matyoungblood/Chemical-Detector/HOUSING/diagram_files/7938.gif

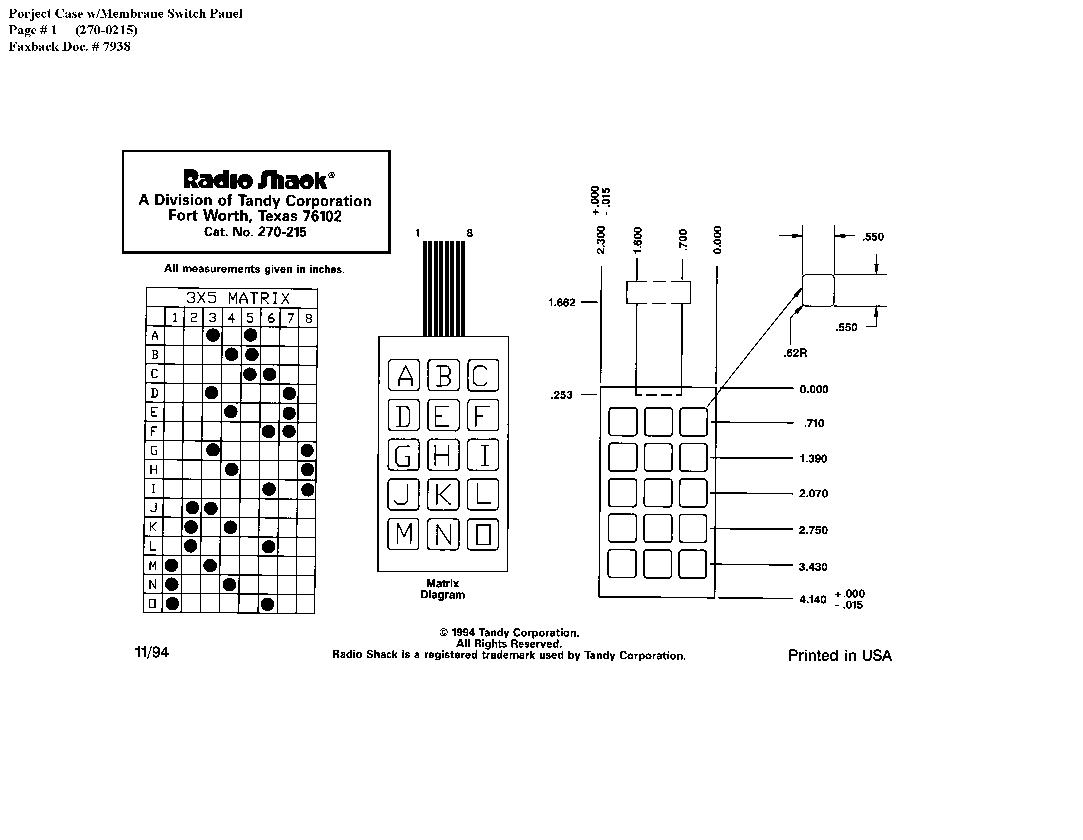
HOUSING/diagram_files/7938.gif
