matyoungblood/Chemical-Detector/HOUSING/diagram_files/7938002.gif

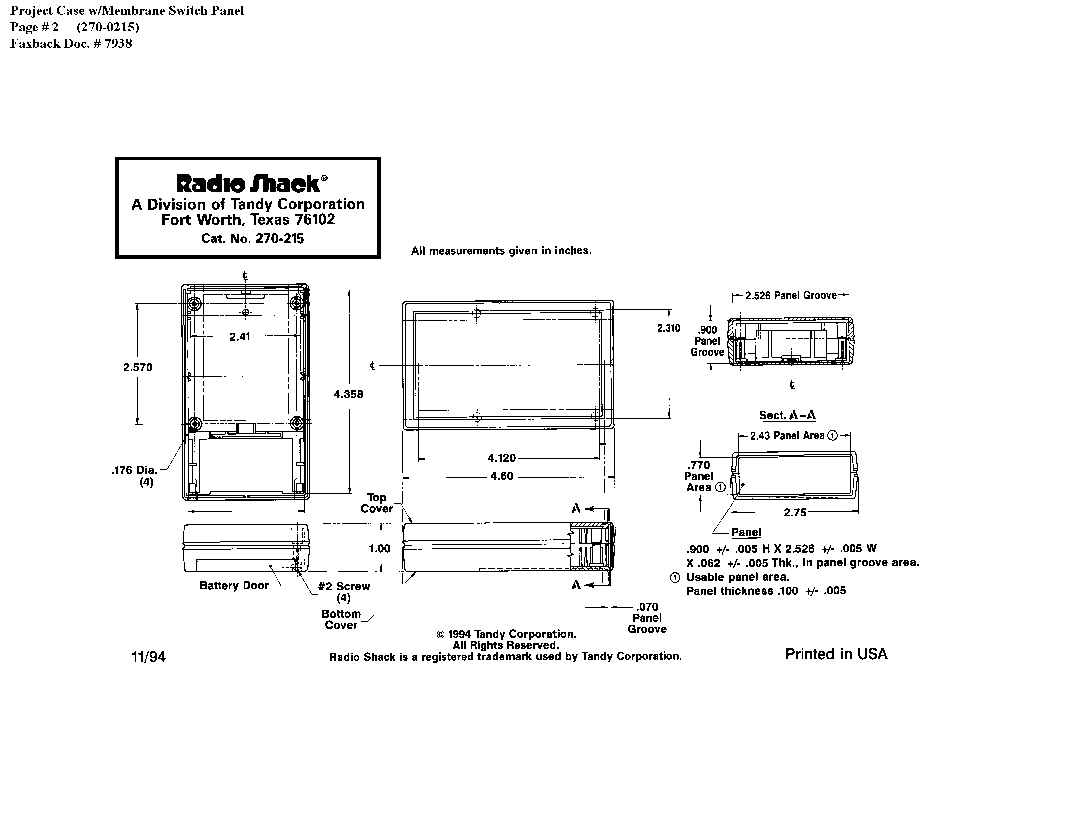
HOUSING/diagram_files/7938002.gif
