matyoungblood/Chemical-Detector/HOUSING/schematic_drawings_files/16198.gif

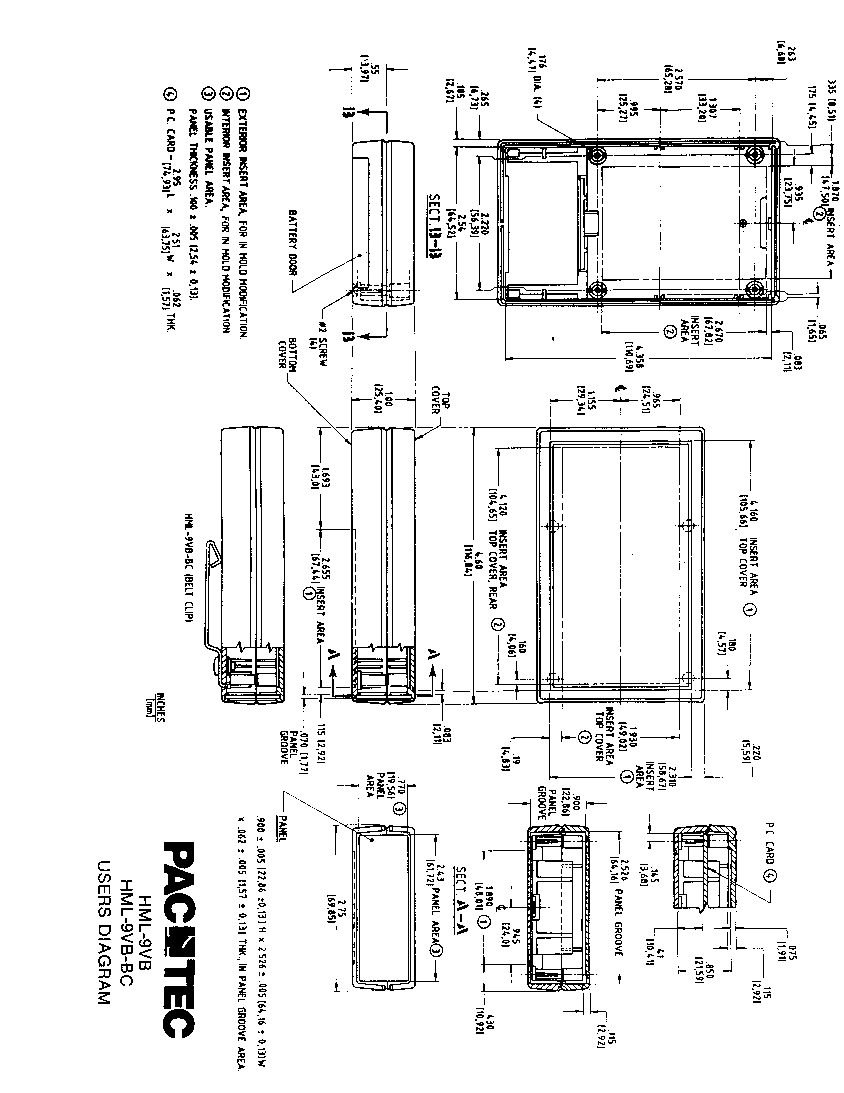
HOUSING/schematic_drawings_files/16198.gif
