matyoungblood/Chemical-Detector/PCB.modernformat/LAYOUT/TEST_POINT.txt

(DEVICE DESCRIPTION FILE: TEST_POINT)
PACKAGE TP_TP1
PACKAGEPROP HEIGHT '1.0000000'
PACKAGEPROP ALT_SYMBOLS '(TP_TP2;TP_TP3;TP;TP_TP5)'
CLASS IC
PINCOUNT 1
END
