matyoungblood/Chemical-Detector/(list of files, drawings)

Other design files:
SCHEMATICS/DESIGN1.DSN
SCHEMATICS/DESIGN1.opj
