matyoungblood/Chemical-Detector/(commit log)

2021-10-02 Initial Work
    2003 Senior Design Project
    [2_to_the_x_lookup_table_sketchpad.xls, 3_24_03.xls, 4_7_2003.xls, DESIGN1.DSN, DESIGN1.opj, FINAL_SENSOR_DATA.xls, coefficients.xls, coefficients_for_calculating_dose.xls]
2021-10-03 Upgrade to modern Allegro format
    [DESIGN1.opj, DETECTOR.brd]
